bublinak/PocKETlab/hardware/PocKETlab.kicad_pcb

## KiCad design hardware/PocKETlab.kicad_pcb (2025-05-15)

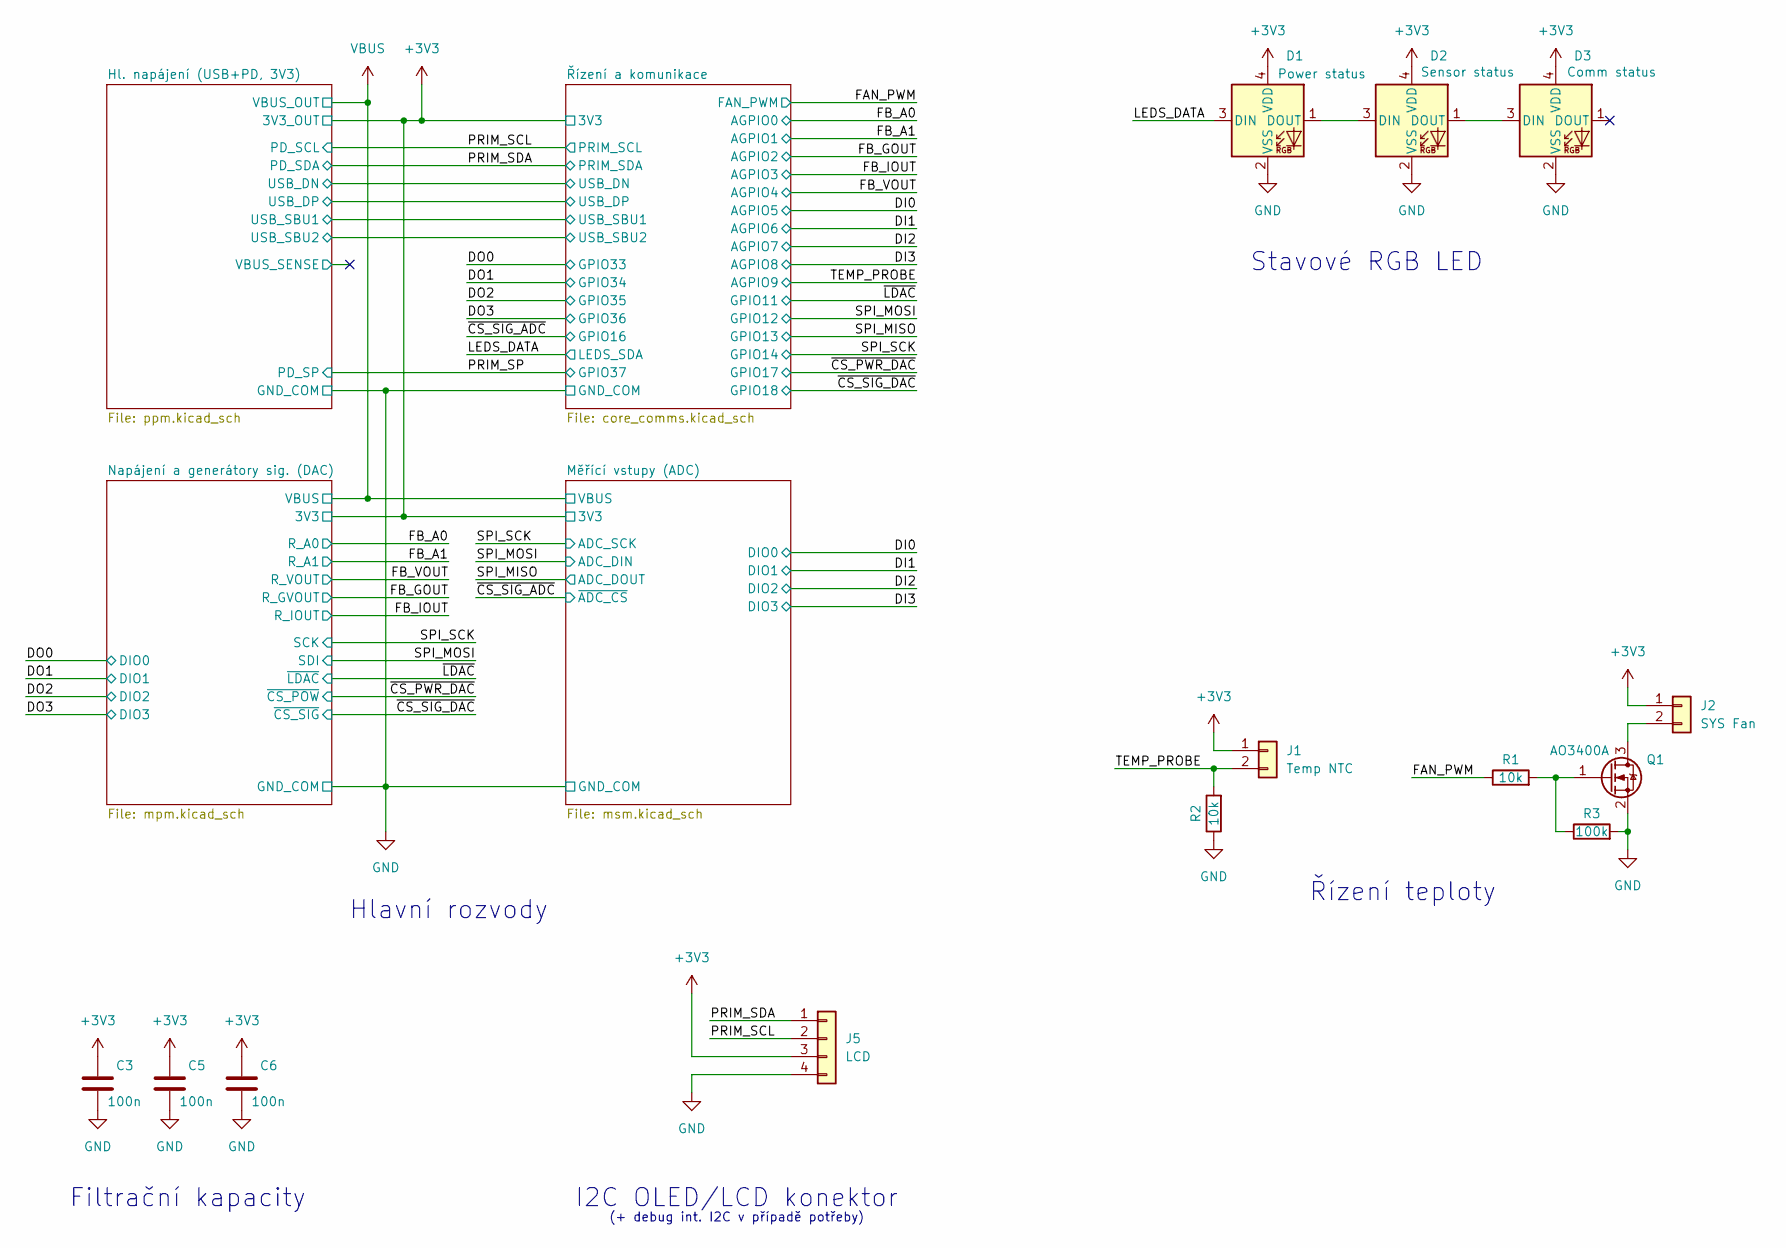
[picture p1: schematic PocKETlab.kicad_sch]

Parts:
C3, C5, C6: 100n; C_0603_1608Metric; LCSC Part C14663
D1: Power status; LED_WS2812B-2020_PLCC4_2.0x2.0mm; LCSC Part C5349955
D2: Sensor status; LED_WS2812B-2020_PLCC4_2.0x2.0mm; LCSC Part C5349955
D3: Comm status; LED_WS2812B-2020_PLCC4_2.0x2.0mm; LCSC Part C5349955
J1: Temp NTC; JST_PH_B2B-PH-K_1x02_P2.00mm_Vertical
J2: SYS Fan; JST_PH_B2B-PH-K_1x02_P2.00mm_Vertical
J5: LCD; JST_PH_B4B-PH-K_1x04_P2.00mm_Vertical
Q1: AO3400A; SOT-23; LCSC Part C20917
R1, R2: 10k; R_0603_1608Metric; LCSC Part C25804
R3: 100k; R_0603_1608Metric; LCSC Part C15458

Connections:
+3V3: C3.1, C5.1, C6.1, D1.4 (VDD), D2.4 (VDD), D3.4 (VDD), J1.1, J2.1, J5.3; also elsewhere on the board
/FAN_PWM: R1.1; also elsewhere on the board
/LEDS_DATA: D1.3 (DIN); also elsewhere on the board
/PRIM_SCL: J5.2; also elsewhere on the board
/PRIM_SDA: J5.1; also elsewhere on the board
/TEMP_PROBE: J1.2, R2.2; also elsewhere on the board
GND: C3.2, C5.2, C6.2, D1.2 (VSS), D2.2 (VSS), D3.2 (VSS), J5.4, Q1.2 (S), R2.1, R3.2; also elsewhere on the board
unnamed: D1.1 (DOUT), D2.3 (DIN)
unnamed: D2.1 (DOUT), D3.3 (DIN)
unnamed: J2.2, Q1.3 (D)
unnamed: Q1.1 (G), R1.2, R3.1

Notes on the sheet:
Hlavní rozvody
Řízení teploty
(+ debug int. I2C v případě potřeby)
I2C OLED/LCD konektor
Stavové RGB LED
Filtrační kapacity

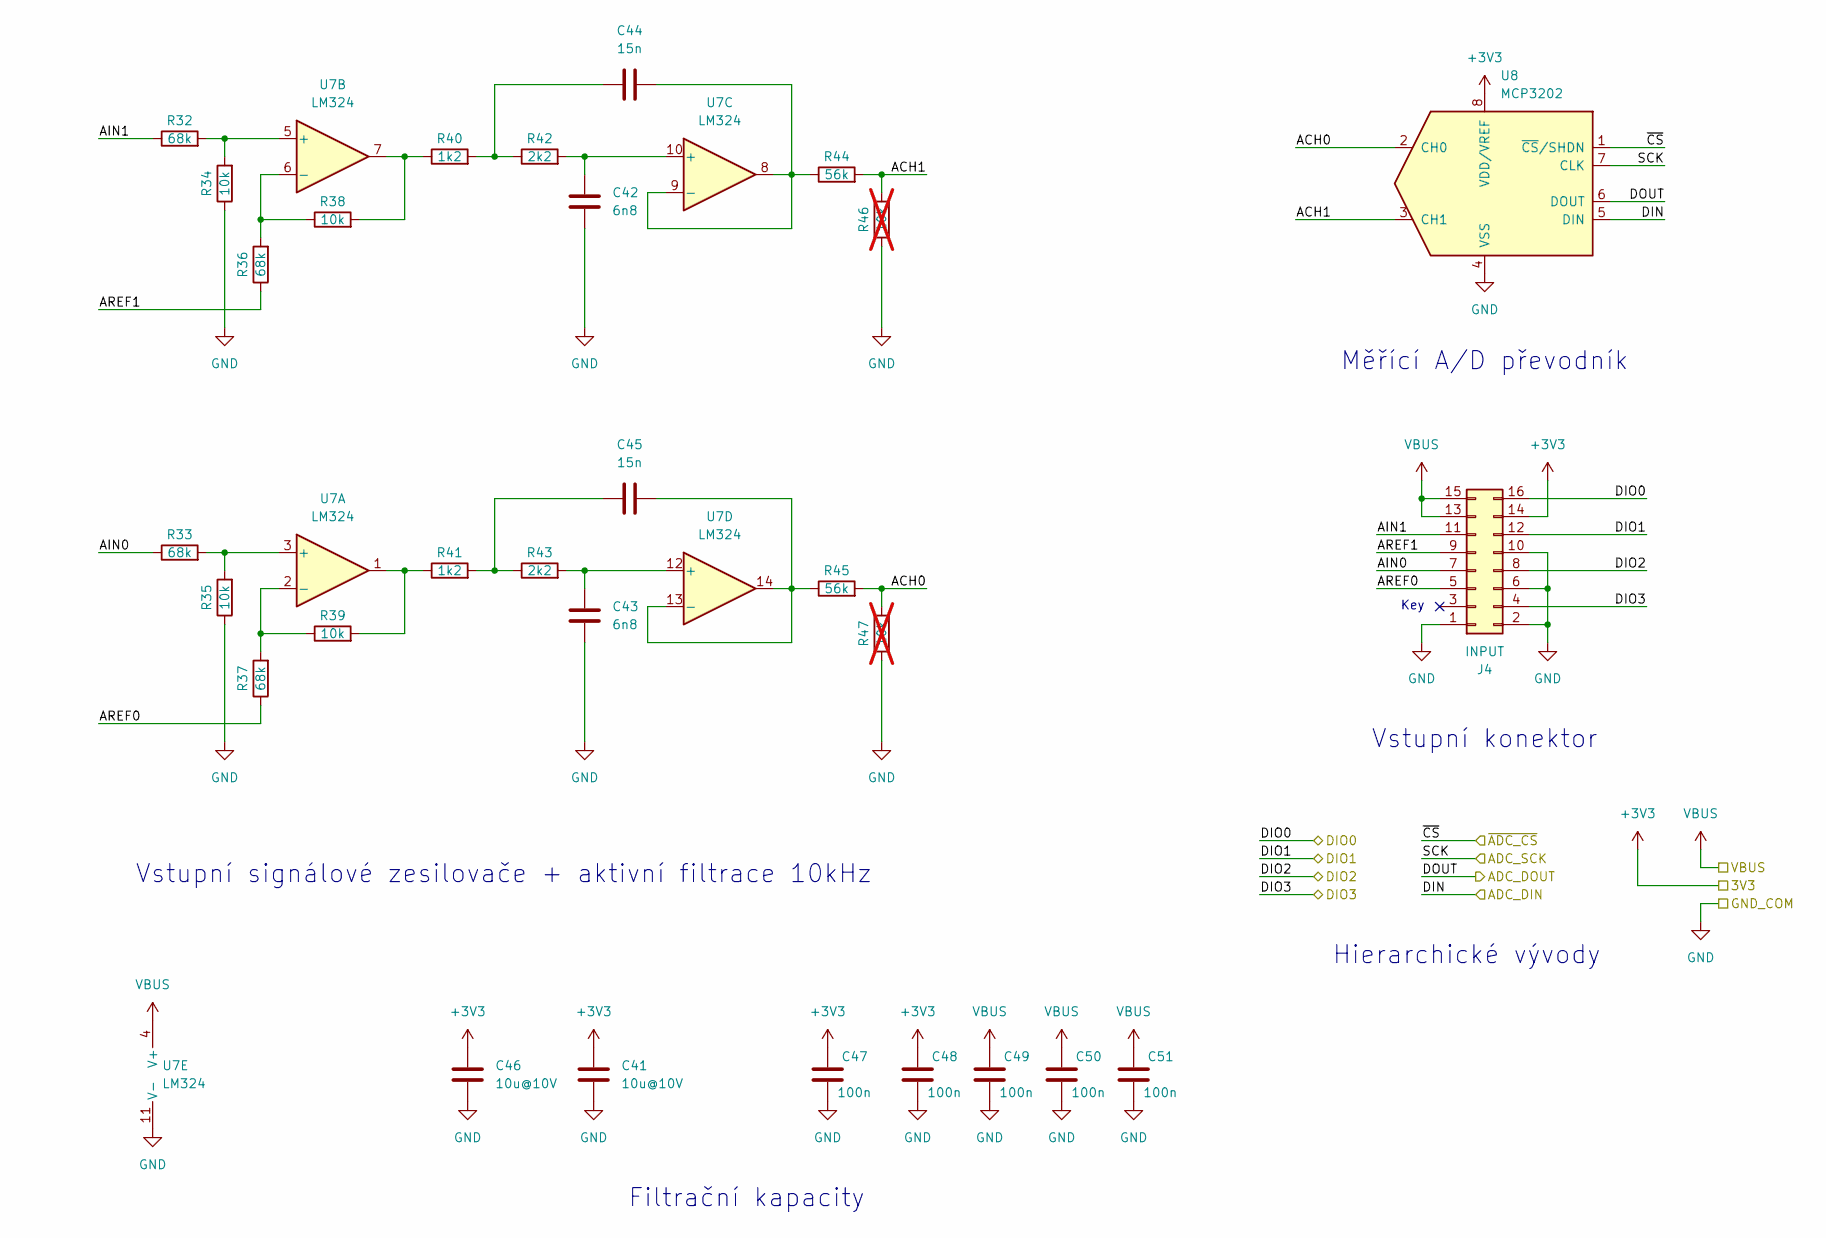
[picture p2: schematic msm.kicad_sch, PocKETlab]

Parts:
C41, C46: 10u@10V; C_0603_1608Metric; LCSC Part C96446
C42, C43: 6n8; C_0603_1608Metric; LCSC Part C1631
C44, C45: 15n; C_0603_1608Metric; LCSC Part C1596
C47, C48, C49, C50, C51: 100n; C_0603_1608Metric; LCSC Part C14663
J4: INPUT; PinSocket_2x08_P2.54mm_Vertical_SMD_HOLE; LCSC Part C42163136
R32, R33, R36, R37: 68k; R_0603_1608Metric; LCSC Part C23231
R34, R35, R38, R39: 10k; R_0603_1608Metric; LCSC Part C25804
R40, R41: 1k2; R_0603_1608Metric; LCSC Part C22765
R42, R43: 2k2; R_0603_1608Metric; LCSC Part C4190
R44, R45: 56k; R_0603_1608Metric; LCSC Part C23206
R46, R47: 10k; R_0603_1608Metric; LCSC Part C25804; not fitted
U7: LM324; SOIC-14_3.9x8.7mm_P1.27mm; LCSC Part C7943
U8: MCP3202; SOIC-8_3.9x4.9mm_P1.27mm; LCSC Part C56997

Connections:
+3V3: C41.1, C46.1, C47.1, C48.1, J4.14, U8.8 (VDD/VREF); also elsewhere on the board
/DI0: J4.16; also elsewhere on the board
/DI1: J4.12; also elsewhere on the board
/DI2: J4.8; also elsewhere on the board
/DI3: J4.4; also elsewhere on the board
/Měřící vstupy (ADC)/ACH0: R45.2, R47.2, U8.2 (CH0)
/Měřící vstupy (ADC)/ACH1: R44.2, R46.2, U8.3 (CH1)
/Měřící vstupy (ADC)/AIN0: J4.7, R33.1
/Měřící vstupy (ADC)/AIN1: J4.11, R32.1
/Měřící vstupy (ADC)/AREF0: J4.5, R37.1
/Měřící vstupy (ADC)/AREF1: J4.9, R36.1
/SPI_MISO: U8.6 (DOUT); also elsewhere on the board
/SPI_MOSI: U8.5 (DIN); also elsewhere on the board
/SPI_SCK: U8.7 (CLK); also elsewhere on the board
/~CS_SIG_ADC: U8.1 (~CS/SHDN); also elsewhere on the board
GND: C41.2, C42.2, C43.2, C46.2, C47.2, C48.2, C49.2, C50.2, C51.2, J4.1, J4.2, J4.6, J4.10, R34.1, R35.1, R46.1, R47.1, U7.11 (V-), U8.4 (VSS); also elsewhere on the board
unnamed: C44.1, R40.2, R42.1
unnamed: C45.1, R41.2, R43.1
unnamed: R38.2, R40.1, U7.7
unnamed: R39.2, R41.1, U7.1
unnamed: R33.2, R35.2, U7.3 (+)
unnamed: R37.2, R39.1, U7.2 (-)
unnamed: R32.2, R34.2, U7.5 (+)
unnamed: R36.2, R38.1, U7.6 (-)
unnamed: C42.1, R42.2, U7.10 (+)
unnamed: C44.2, R44.1, U7.8, U7.9 (-)
unnamed: C43.1, R43.2, U7.12 (+)
unnamed: C45.2, R45.1, U7.13 (-), U7.14
VBUS: C49.1, C50.1, C51.1, J4.13, J4.15, U7.4 (V+); also elsewhere on the board

Notes on the sheet:
Hierarchické vývody
Vstupní konektor
Vstupní signálové zesilovače + aktivní filtrace 10kHz
Key
Měřící A/D převodník
Filtrační kapacity

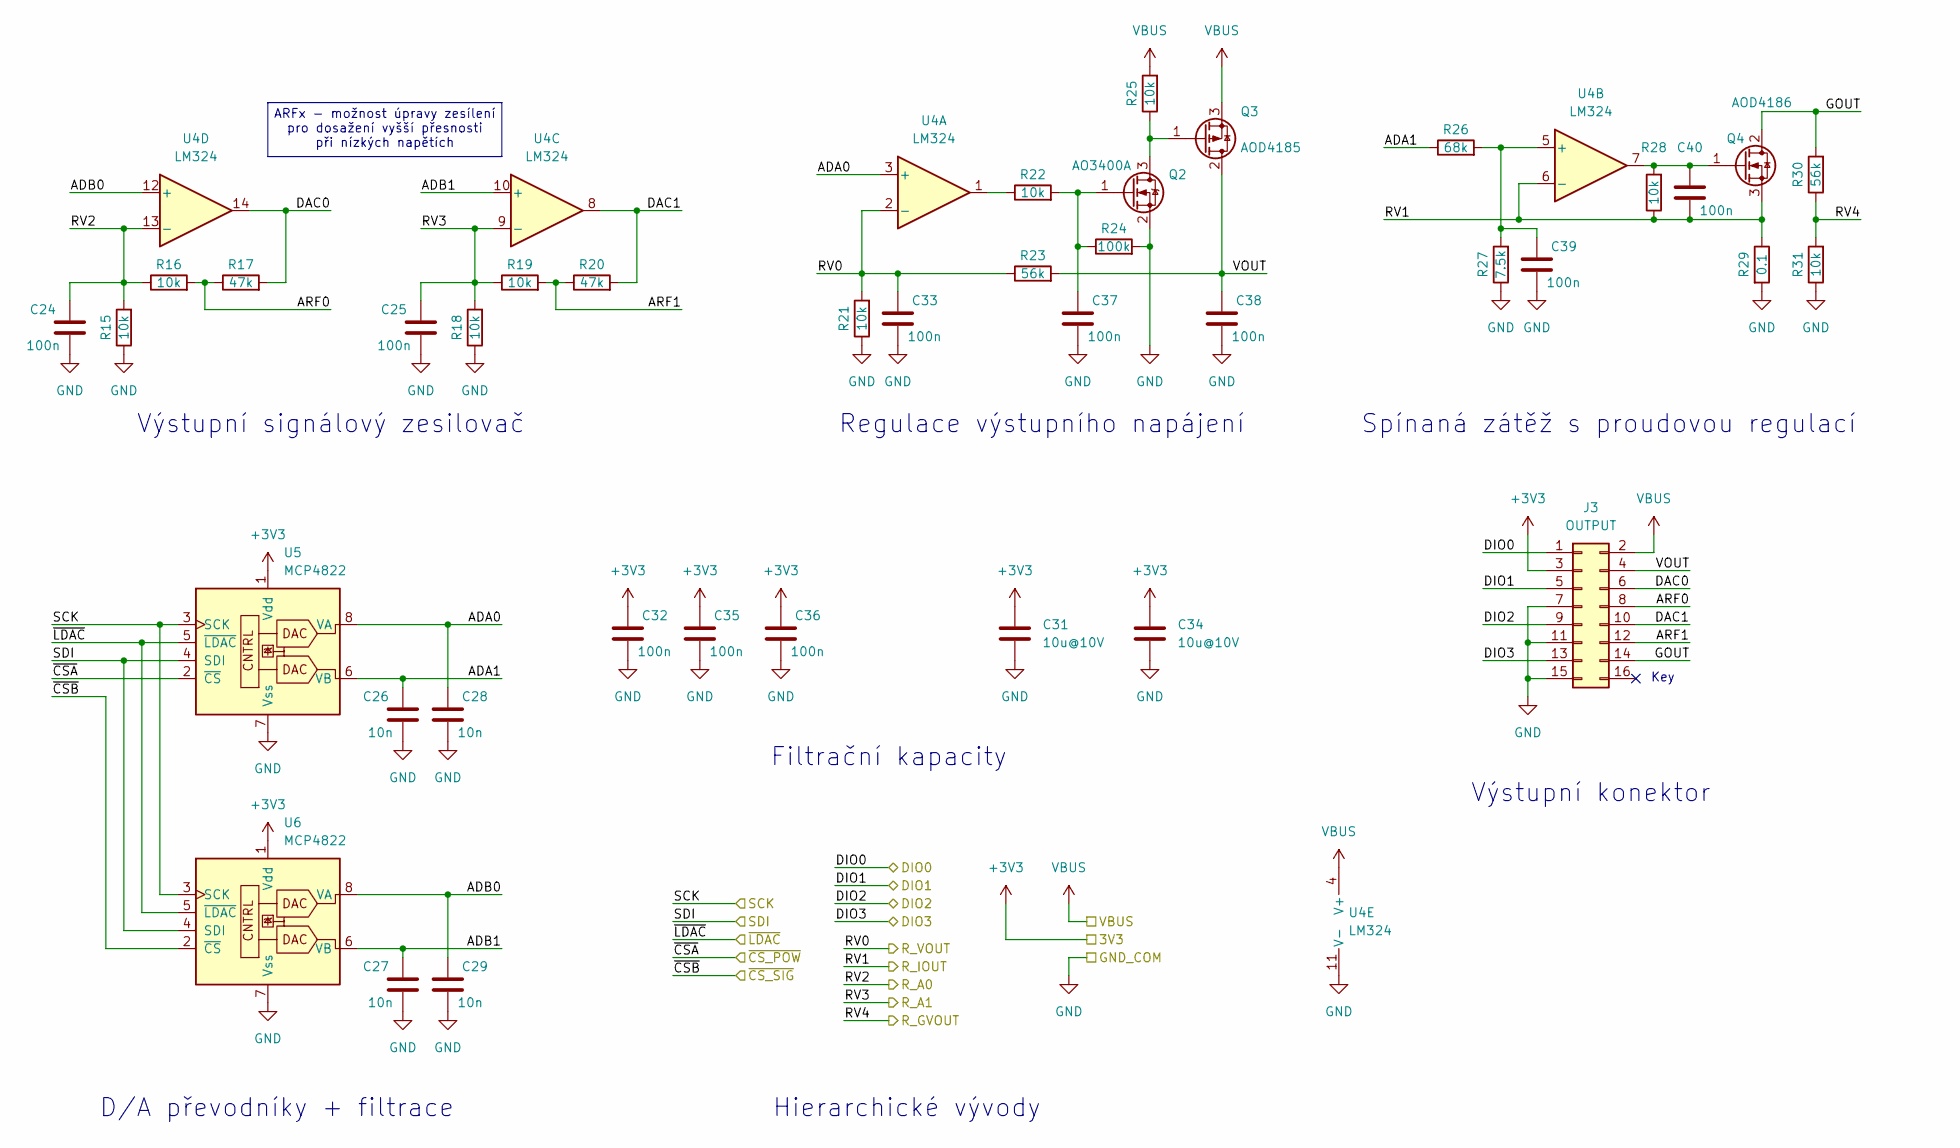
[picture p3: schematic mpm.kicad_sch, PocKETlab]

Parts:
C24, C25, C32, C33, C35, C36, C37, C38, C39, C40: 100n; C_0603_1608Metric; LCSC Part C14663
C26, C27, C28, C29: 10n; C_0603_1608Metric; LCSC Part C1588
C31, C34: 10u@10V; C_0603_1608Metric; LCSC Part C96446
J3: OUTPUT; PinSocket_2x08_P2.54mm_Vertical_SMD_HOLE; LCSC Part C42163136
Q2: AO3400A; SOT-23; LCSC Part C20917
Q3: AOD4185; TO-252-2; LCSC Part C77993
Q4: AOD4186; TO-252-2; LCSC Part C111914
R15, R16, R18, R19, R21, R22, R25, R28, R31: 10k; R_0603_1608Metric; LCSC Part C25804
R17, R20: 47k; R_0603_1608Metric; LCSC Part C25819
R23, R30: 56k; R_0603_1608Metric; LCSC Part C23206
R24: 100k; R_0603_1608Metric; LCSC Part C15458
R26: 68k; R_0603_1608Metric; LCSC Part C23231
R27: 7.5k; R_0603_1608Metric; LCSC Part C23234
R29: 0.1; R_1206_3216Metric; LCSC Part C25334
U4: LM324; SOIC-14_3.9x8.7mm_P1.27mm; LCSC Part C7943
U5, U6: MCP4822; SOIC-8_3.9x4.9mm_P1.27mm; LCSC Part C623653

Connections:
+3V3: C31.1, C32.1, C34.1, C35.1, C36.1, J3.3, U5.1 (Vdd), U6.1 (Vdd); also elsewhere on the board
/DO0: J3.1; also elsewhere on the board
/DO1: J3.5; also elsewhere on the board
/DO2: J3.9; also elsewhere on the board
/DO3: J3.13; also elsewhere on the board
/FB_A0: C24.1, R15.2, R16.1, U4.13 (-); also elsewhere on the board
/FB_A1: C25.1, R18.2, R19.1, U4.9 (-); also elsewhere on the board
/FB_GOUT: R30.1, R31.2; also elsewhere on the board
/FB_IOUT: C40.2, Q4.3 (S), R28.1, R29.1, U4.6 (-); also elsewhere on the board
/FB_VOUT: C33.1, R21.2, R23.1, U4.2 (-); also elsewhere on the board
/Napájení a generátory sig. (DAC)/ADA0: C28.1, U4.3 (+), U5.8 (VA)
/Napájení a generátory sig. (DAC)/ADA1: C26.1, R26.1, U5.6 (VB)
/Napájení a generátory sig. (DAC)/ADB0: C29.1, U4.12 (+), U6.8 (VA)
/Napájení a generátory sig. (DAC)/ADB1: C27.1, U4.10 (+), U6.6 (VB)
/Napájení a generátory sig. (DAC)/ARF0: J3.8, R16.2, R17.1
/Napájení a generátory sig. (DAC)/ARF1: J3.12, R19.2, R20.1
/Napájení a generátory sig. (DAC)/DAC0: J3.6, R17.2, U4.14
/Napájení a generátory sig. (DAC)/DAC1: J3.10, R20.2, U4.8
/Napájení a generátory sig. (DAC)/GOUT: J3.14, Q4.2 (D), R30.2
/Napájení a generátory sig. (DAC)/VOUT: C38.1, J3.4, Q3.2 (D), R23.2
/SPI_MOSI: U5.4 (SDI), U6.4 (SDI); also elsewhere on the board
/SPI_SCK: U5.3 (SCK), U6.3 (SCK); also elsewhere on the board
/~CS_PWR_DAC: U5.2 (~CS); also elsewhere on the board
/~CS_SIG_DAC: U6.2 (~CS); also elsewhere on the board
/~LDAC: U5.5 (~LDAC), U6.5 (~LDAC); also elsewhere on the board
GND: C24.2, C25.2, C26.2, C27.2, C28.2, C29.2, C31.2, C32.2, C33.2, C34.2, C35.2, C36.2, C37.2, C38.2, C39.2, J3.7, J3.11, J3.15, Q2.2 (S), R15.1, R18.1, R21.1, R24.2, R27.1, R29.2, R31.1, U4.11 (V-), U5.7 (Vss), U6.7 (Vss); also elsewhere on the board
unnamed: Q2.3 (D), Q3.1 (G), R25.1
unnamed: C37.1, Q2.1 (G), R22.2, R24.1
unnamed: C40.1, Q4.1 (G), R28.2, U4.7
unnamed: R22.1, U4.1
unnamed: C39.1, R26.2, R27.2, U4.5 (+)
VBUS: J3.2, Q3.3 (S), R25.2, U4.4 (V+); also elsewhere on the board

Notes on the sheet:
Regulace výstupního napájení
Hierarchické vývody
Výstupní signálový zesilovač
D/A převodníky + filtrace
Spínaná zátěž s proudovou regulací
ARFx - možnost úpravy zesílení pro dosažení vyšší přesnosti při nízkých napětích
Key
Filtrační kapacity
Výstupní konektor

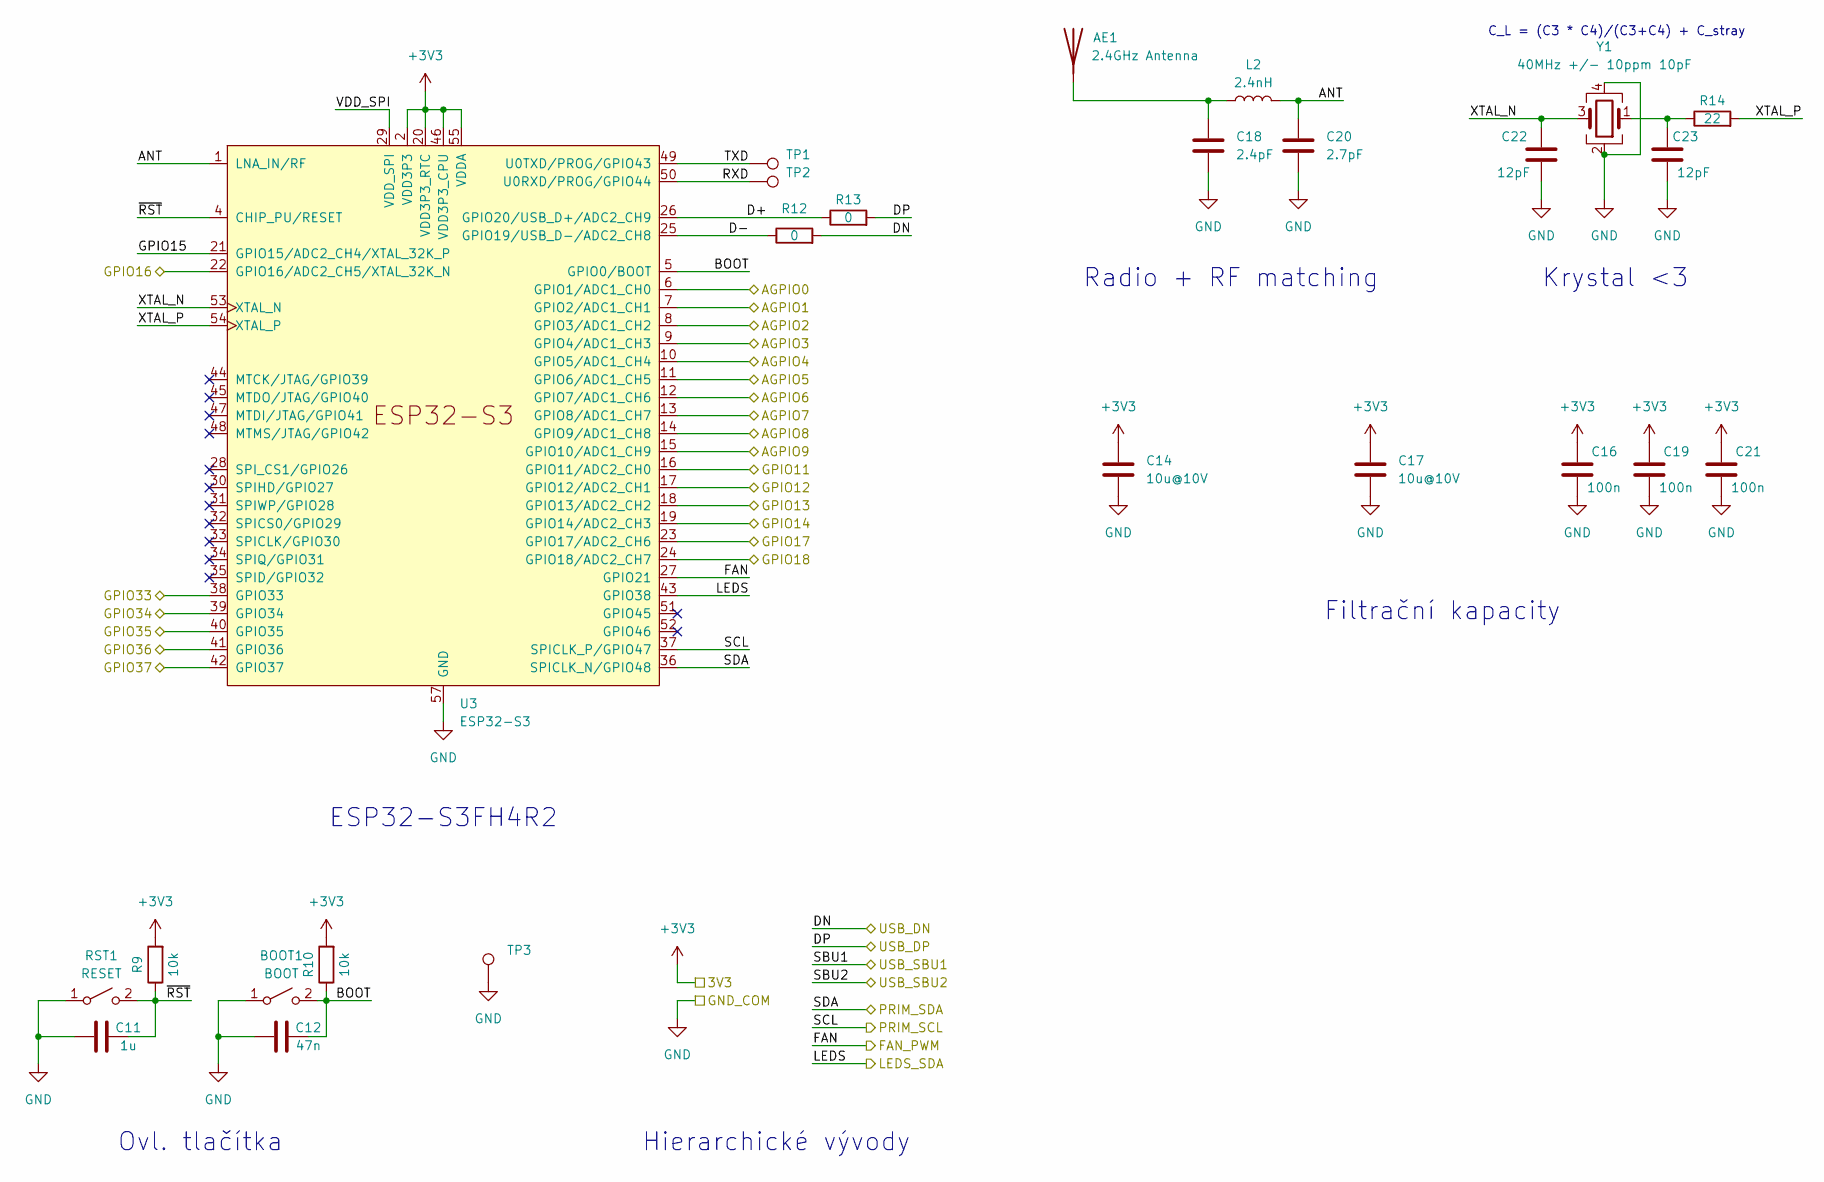
[picture p4: schematic core_comms.kicad_sch, PocKETlab]

Parts:
AE1: 2.4GHz Antenna; Johanson_2450AT18x100; LCSC Part C89334
BOOT1: BOOT; SW_Push_1P1T_NO_CK_KMR2; LCSC Part C72443
C11: 1u; C_0603_1608Metric; LCSC Part C15849
C12: 47n; C_0603_1608Metric; LCSC Part C1622
C14, C17: 10u@10V; C_0603_1608Metric; LCSC Part C96446
C16, C19, C21: 100n; C_0603_1608Metric; LCSC Part C14663
C18: 2.4pF; C_0402_1005Metric; LCSC Part C260623
C20: 2.7pF; C_0402_1005Metric; LCSC Part C277484
C22, C23: 12pF; C_0402_1005Metric; LCSC Part C1547
L2: 2.4nH; L_0402_1005Metric; LCSC Part C97997
R9, R10: 10k; R_0603_1608Metric; LCSC Part C25804
R12, R13: 0; R_0402_1005Metric; LCSC Part C17168
R14: 22; R_0402_1005Metric; LCSC Part C25092
RST1: RESET; SW_Push_1P1T_NO_CK_KMR2; LCSC Part C72443
TP1, TP2, TP3: TestPoint; TestPoint_Pad_D1.5mm
U3: ESP32-S3; QFN-56-1EP_7x7mm_P0.4mm_EP5.6x5.6mm; LCSC Part C3013940
Y1: 40MHz +/- 10ppm 10pF; Crystal_SMD_2016-4Pin_2.0x1.6mm; LCSC Part C255898

Connections:
+3V3: C14.1, C16.1, C17.1, C19.1, C21.1, R9.2, R10.2, U3.2 (VDD3P3), U3.3 (VDD3P3), U3.20 (VDD3P3_RTC), U3.46 (VDD3P3_CPU), U3.55 (VDDA), U3.56 (VDDA); also elsewhere on the board
/DI0: U3.11 (GPIO6/ADC1_CH5); also elsewhere on the board
/DI1: U3.12 (GPIO7/ADC1_CH6); also elsewhere on the board
/DI2: U3.13 (GPIO8/ADC1_CH7); also elsewhere on the board
/DI3: U3.14 (GPIO9/ADC1_CH8); also elsewhere on the board
/DO0: U3.38 (GPIO33); also elsewhere on the board
/DO1: U3.39 (GPIO34); also elsewhere on the board
/DO2: U3.40 (GPIO35); also elsewhere on the board
/DO3: U3.41 (GPIO36); also elsewhere on the board
/FAN_PWM: U3.27 (GPIO21); also elsewhere on the board
/FB_A0: U3.6 (GPIO1/ADC1_CH0); also elsewhere on the board
/FB_A1: U3.7 (GPIO2/ADC1_CH1); also elsewhere on the board
/FB_GOUT: U3.8 (GPIO3/ADC1_CH2); also elsewhere on the board
/FB_IOUT: U3.9 (GPIO4/ADC1_CH3); also elsewhere on the board
/FB_VOUT: U3.10 (GPIO5/ADC1_CH4); also elsewhere on the board
/Hl. napájení (USB+PD, 3V3)/DN: R12.2; also elsewhere on the board
/Hl. napájení (USB+PD, 3V3)/DP: R13.2; also elsewhere on the board
/LEDS_DATA: U3.43 (GPIO38); also elsewhere on the board
/PRIM_SCL: U3.37 (SPICLK_P/GPIO47); also elsewhere on the board
/PRIM_SDA: U3.36 (SPICLK_N/GPIO48); also elsewhere on the board
/PRIM_SP: U3.42 (GPIO37); also elsewhere on the board
/SPI_MISO: U3.18 (GPIO13/ADC2_CH2); also elsewhere on the board
/SPI_MOSI: U3.17 (GPIO12/ADC2_CH1); also elsewhere on the board
/SPI_SCK: U3.19 (GPIO14/ADC2_CH3); also elsewhere on the board
/TEMP_PROBE: U3.15 (GPIO10/ADC1_CH9); also elsewhere on the board
/~CS_PWR_DAC: U3.23 (GPIO17/ADC2_CH6); also elsewhere on the board
/~CS_SIG_ADC: U3.22 (GPIO16/ADC2_CH5/XTAL_32K_N); also elsewhere on the board
/~CS_SIG_DAC: U3.24 (GPIO18/ADC2_CH7); also elsewhere on the board
/~LDAC: U3.16 (GPIO11/ADC2_CH0); also elsewhere on the board
/Řízení a komunikace/ANT: C20.1, L2.2, U3.1 (LNA_IN/RF)
/Řízení a komunikace/BOOT: BOOT1.2 (B), C12.1, R10.1, U3.5 (GPIO0/BOOT)
/Řízení a komunikace/D+: R13.1, U3.26 (GPIO20/USB_D+/ADC2_CH9)
/Řízení a komunikace/D-: R12.1, U3.25 (GPIO19/USB_D-/ADC2_CH8)
/Řízení a komunikace/GPIO15: U3.21 (GPIO15/ADC2_CH4/XTAL_32K_P)
/Řízení a komunikace/RXD: TP2.1, U3.50 (U0RXD/PROG/GPIO44)
/Řízení a komunikace/TXD: TP1.1, U3.49 (U0TXD/PROG/GPIO43)
/Řízení a komunikace/VDD_SPI: U3.29 (VDD_SPI)
/Řízení a komunikace/XTAL_N: C22.1, U3.53 (XTAL_N), Y1.3
/Řízení a komunikace/XTAL_P: R14.2, U3.54 (XTAL_P)
/Řízení a komunikace/~RST: C11.1, R9.1, RST1.2 (B), U3.4 (CHIP_PU/RESET)
GND: BOOT1.1 (A), C11.2, C12.2, C14.2, C16.2, C17.2, C18.2, C19.2, C20.2, C21.2, C22.2, C23.2, RST1.1 (A), TP3.1, U3.57 (GND), Y1.2, Y1.4; also elsewhere on the board
unnamed: AE1.1 (A), C18.1, L2.1
unnamed: C23.1, R14.1, Y1.1

Notes on the sheet:
ESP32-S3FH4R2
Ovl. tlačítka
Krystal <3
Hierarchické vývody
Filtrační kapacity
Radio + RF matching
C_L = (C3 * C4)/(C3+C4) + C_stray

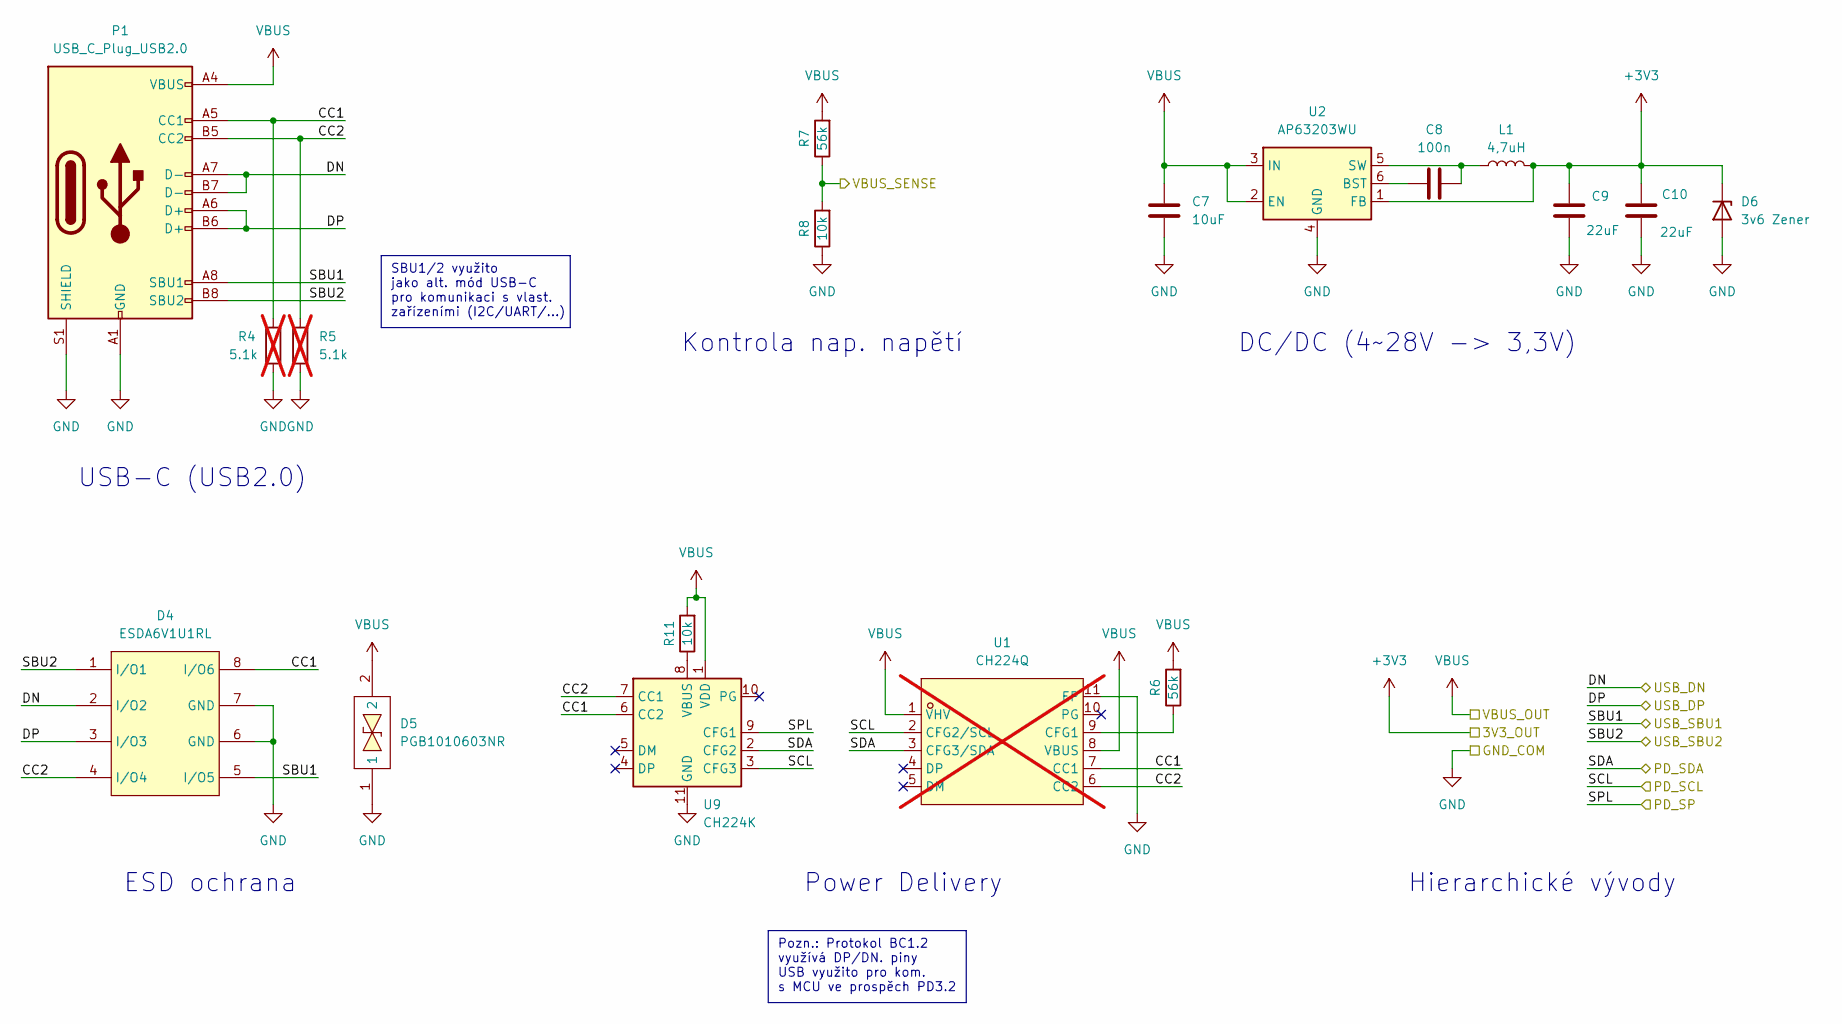
[picture p5: schematic ppm.kicad_sch, PocKETlab]

Parts:
C7: 10uF; C_0603_1608Metric; LCSC Part C19702
C8: 100n; C_0603_1608Metric; LCSC Part C14663
C9, C10: 22uF; C_0603_1608Metric; LCSC Part C59461
D4: ESDA6V1U1RL; SO-8_L4.9-W3.9-P1.27-LS5.9-BL; LCSC Part C118278
D5: PGB1010603NR; D0603-BI; LCSC Part C10677
D6: 3v6 Zener; D_SOD-123; LCSC Part C66886
L1: 4,7uH; IND-SMD_L3.5-W3.0; LCSC Part C915148
P1: USB_C_Plug_USB2.0; USB_C_Receptacle_Palconn_UTC16-G; LCSC Part C165948
R4, R5: 5.1k; R_0402_1005Metric; LCSC Part C25905; not fitted
R6, R7: 56k; R_0603_1608Metric; LCSC Part C23206
R8, R11: 10k; R_0603_1608Metric; LCSC Part C25804
U1: CH224Q; DFN-10_L2.0-W2.0-P0.40-BL-EP; LCSC Part C46061833; not fitted
U2: AP63203WU; TSOT-23-6; LCSC Part C780769
U9: CH224K; SSOP-10-1EP_3.9x4.9mm_P1mm_EP2.1x3.3mm

Connections:
+3V3: C9.2, C10.2, D6.1 (K), L1.2, U2.1 (FB); also elsewhere on the board
/Hl. napájení (USB+PD, 3V3)/CC1: D4.8 (I/O6), P1.A5 (CC1), R4.1, U1.7 (CC1), U9.6 (CC2)
/Hl. napájení (USB+PD, 3V3)/CC2: D4.4 (I/O4), P1.B5 (CC2), R5.1, U1.6 (CC2), U9.7 (CC1)
/Hl. napájení (USB+PD, 3V3)/DN: D4.2 (I/O2), P1.A7 (D-), P1.B7 (D-); also elsewhere on the board
/Hl. napájení (USB+PD, 3V3)/DP: D4.3 (I/O3), P1.A6 (D+), P1.B6 (D+); also elsewhere on the board
/Hl. napájení (USB+PD, 3V3)/SBU1: D4.5 (I/O5), P1.A8 (SBU1)
/Hl. napájení (USB+PD, 3V3)/SBU2: D4.1 (I/O1), P1.B8 (SBU2)
/Hl. napájení (USB+PD, 3V3)/VBUS_SENSE: R7.1, R8.2
/PRIM_SCL: U1.2 (CFG2/SCL), U9.3 (CFG3); also elsewhere on the board
/PRIM_SDA: U1.3 (CFG3/SDA), U9.2 (CFG2); also elsewhere on the board
/PRIM_SP: U9.9 (CFG1); also elsewhere on the board
GND: C7.1, C9.1, C10.1, D4.6 (GND), D4.7 (GND), D5.1, D6.2 (A), P1.A1 (GND), P1.A12 (GND), P1.B1 (GND), P1.B12 (GND), P1.S1 (SHIELD), R4.2, R5.2, R8.1, U1.11 (EP), U2.4 (GND), U9.11 (GND); also elsewhere on the board
unnamed: R6.1, U1.9 (CFG1)
unnamed: C8.1, U2.6 (BST)
unnamed: C8.2, L1.1, U2.5 (SW)
unnamed: R11.1, U9.8 (VBUS)
VBUS: C7.2, D5.2, P1.A4 (VBUS), P1.A9 (VBUS), P1.B4 (VBUS), P1.B9 (VBUS), R6.2, R7.2, R11.2, U1.1 (VHV), U1.8 (VBUS), U2.2 (EN), U2.3 (IN), U9.1 (VDD); also elsewhere on the board

Notes on the sheet:
Pozn.: Protokol BC1.2 využívá DP/DN. piny USB využito pro kom. s MCU ve prospěch PD3.2
Hierarchické vývody
USB-C (USB2.0)
SBU1/2 využito jako alt. mód USB-C pro komunikaci s vlast. zařízeními (I2C/UART/...)
DC/DC (4~28V -> 3,3V)
Kontrola nap. napětí
ESD ochrana
Power Delivery

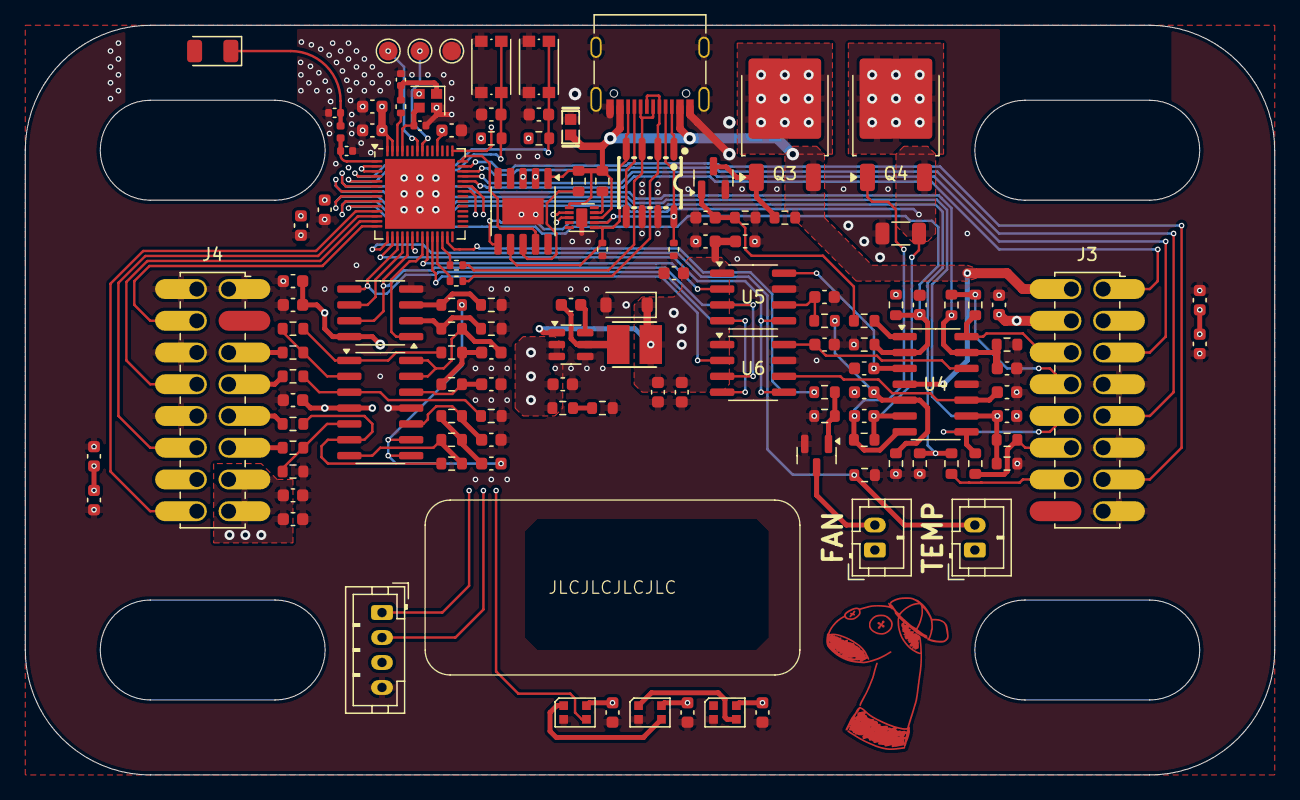
[picture p6: board PocKETlab.kicad_pcb from above]

Board: 4 copper layers, 100.0 x 60.0 mm, 126 parts (0 on the bottom side), 88 nets.
