bublinak/PocKETlab/(commit log)

2025-06-02 big test update before everything falls apart
    [partitions.csv]
2025-11-28 Add testbed grid UI and applet management; update MQTT broker configuration
    - Implemented a responsive grid layout for testbed applets in the web UI.
    - Added functionality for managing applet properties, including gauges, sliders, buttons, and status indicators.
    - Enhanced the applet selection process and updated the UI to reflect selected applet properties.
    - Introduced a dialog for exporting measurement data to CSV with customizable options.
    - Updated the MQTT broker URL to use a public broker for improved connectivity.
    [main.cpp, pin_definitions.h]
