bublinak/PocKETlab/(notices)

Notices in the files:
hardware/ppm.kicad_sch:
Licence: MIT
